armtronix/Wifi-Arduino-85/Schematic_BOM_V_0_4/Assembly Drawing.pdf

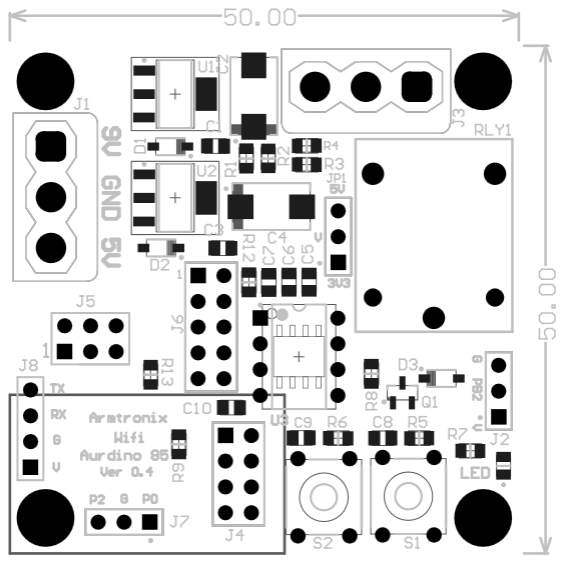
[picture p17: figure]
