armtronix/Wifi-Arduino-85/Schematic_BOM_V_0_4/Wifi_0V8_ 0V4_Corrected.pdf

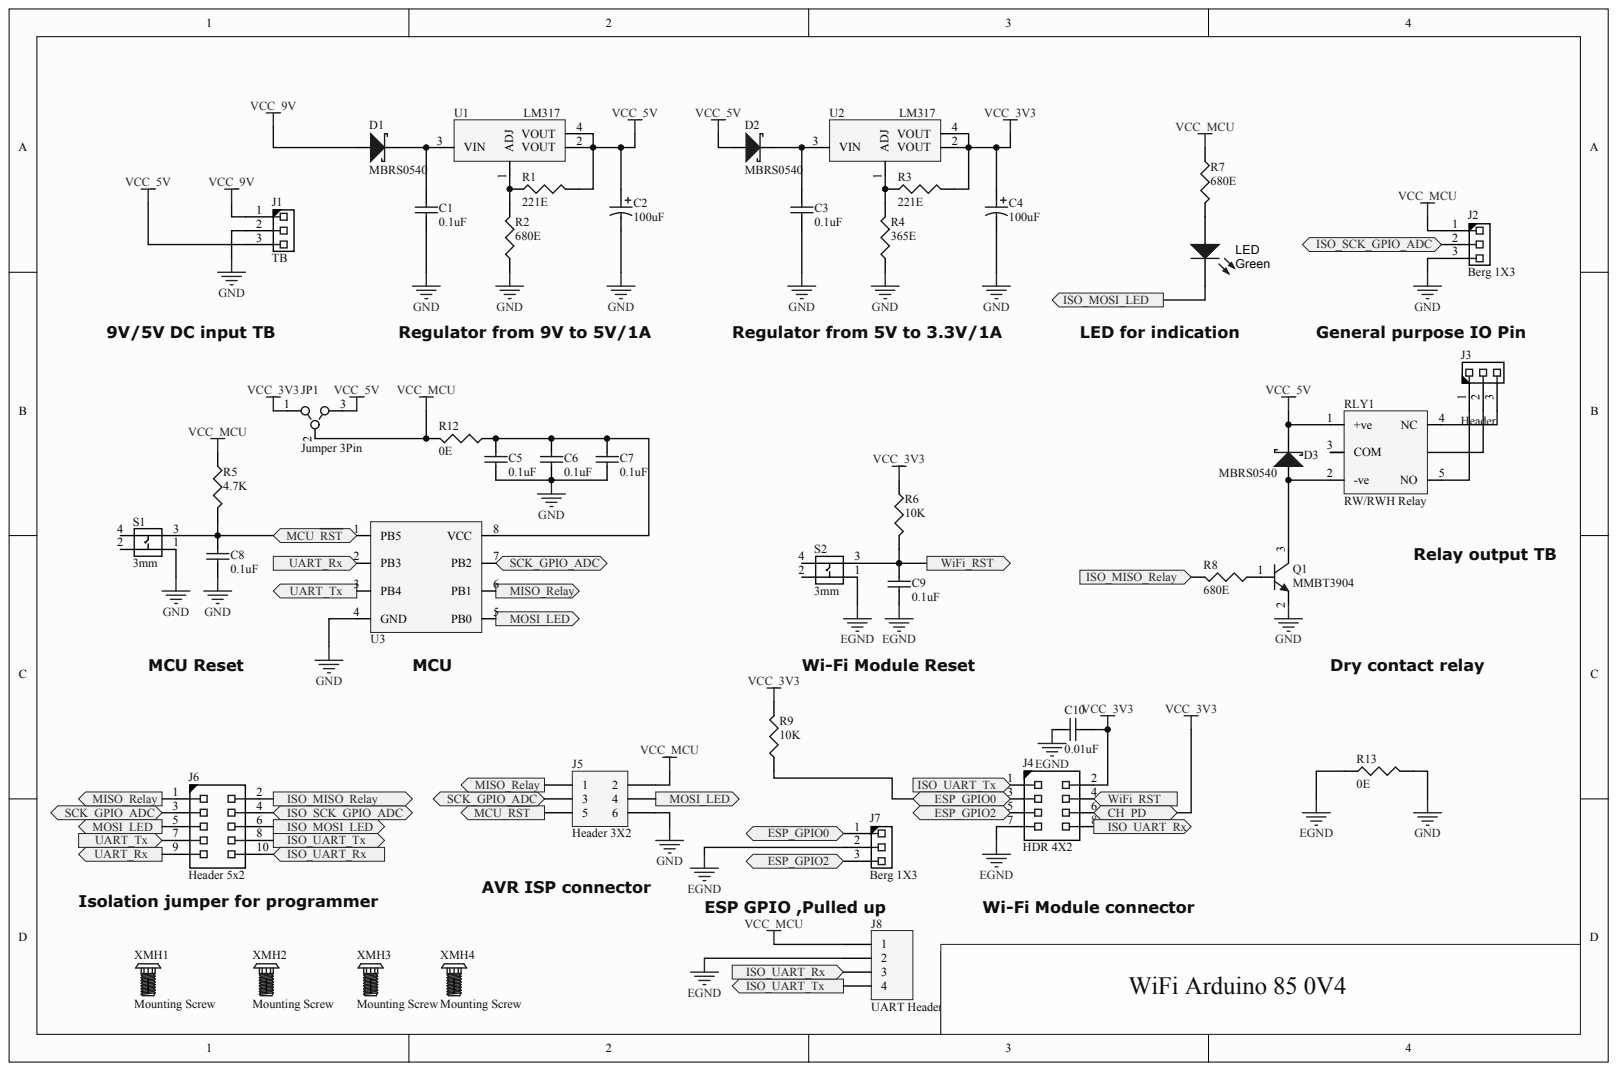
[picture p18: page 1]

General purpose IO Pin

EGND
ESP GPIO ,Pulled up

Isolation jumper for programmer

Wi-Fi Module connector

Wi-Fi Title | Altium Limited L3, 12a Rodborough Rd Frenchs Forest NSW Australia 2086
Size: A4 | WiFi Arduino 85 0V4 Number: 1 | Revision: 0.6

Date: 20-02-2016 Time: AM 09:10:39 | | Sheet 1 of 1
File: D:\PCB Projects\Wifi_Arduino_85\AltiumProject\Wifi 0V4\Wifi 0V8.SchDoc
