armtronix/Wifi-Arduino-85/Schematic_BOM_V_0_4/Wifi Schematic_0V8_ 0V4.pdf

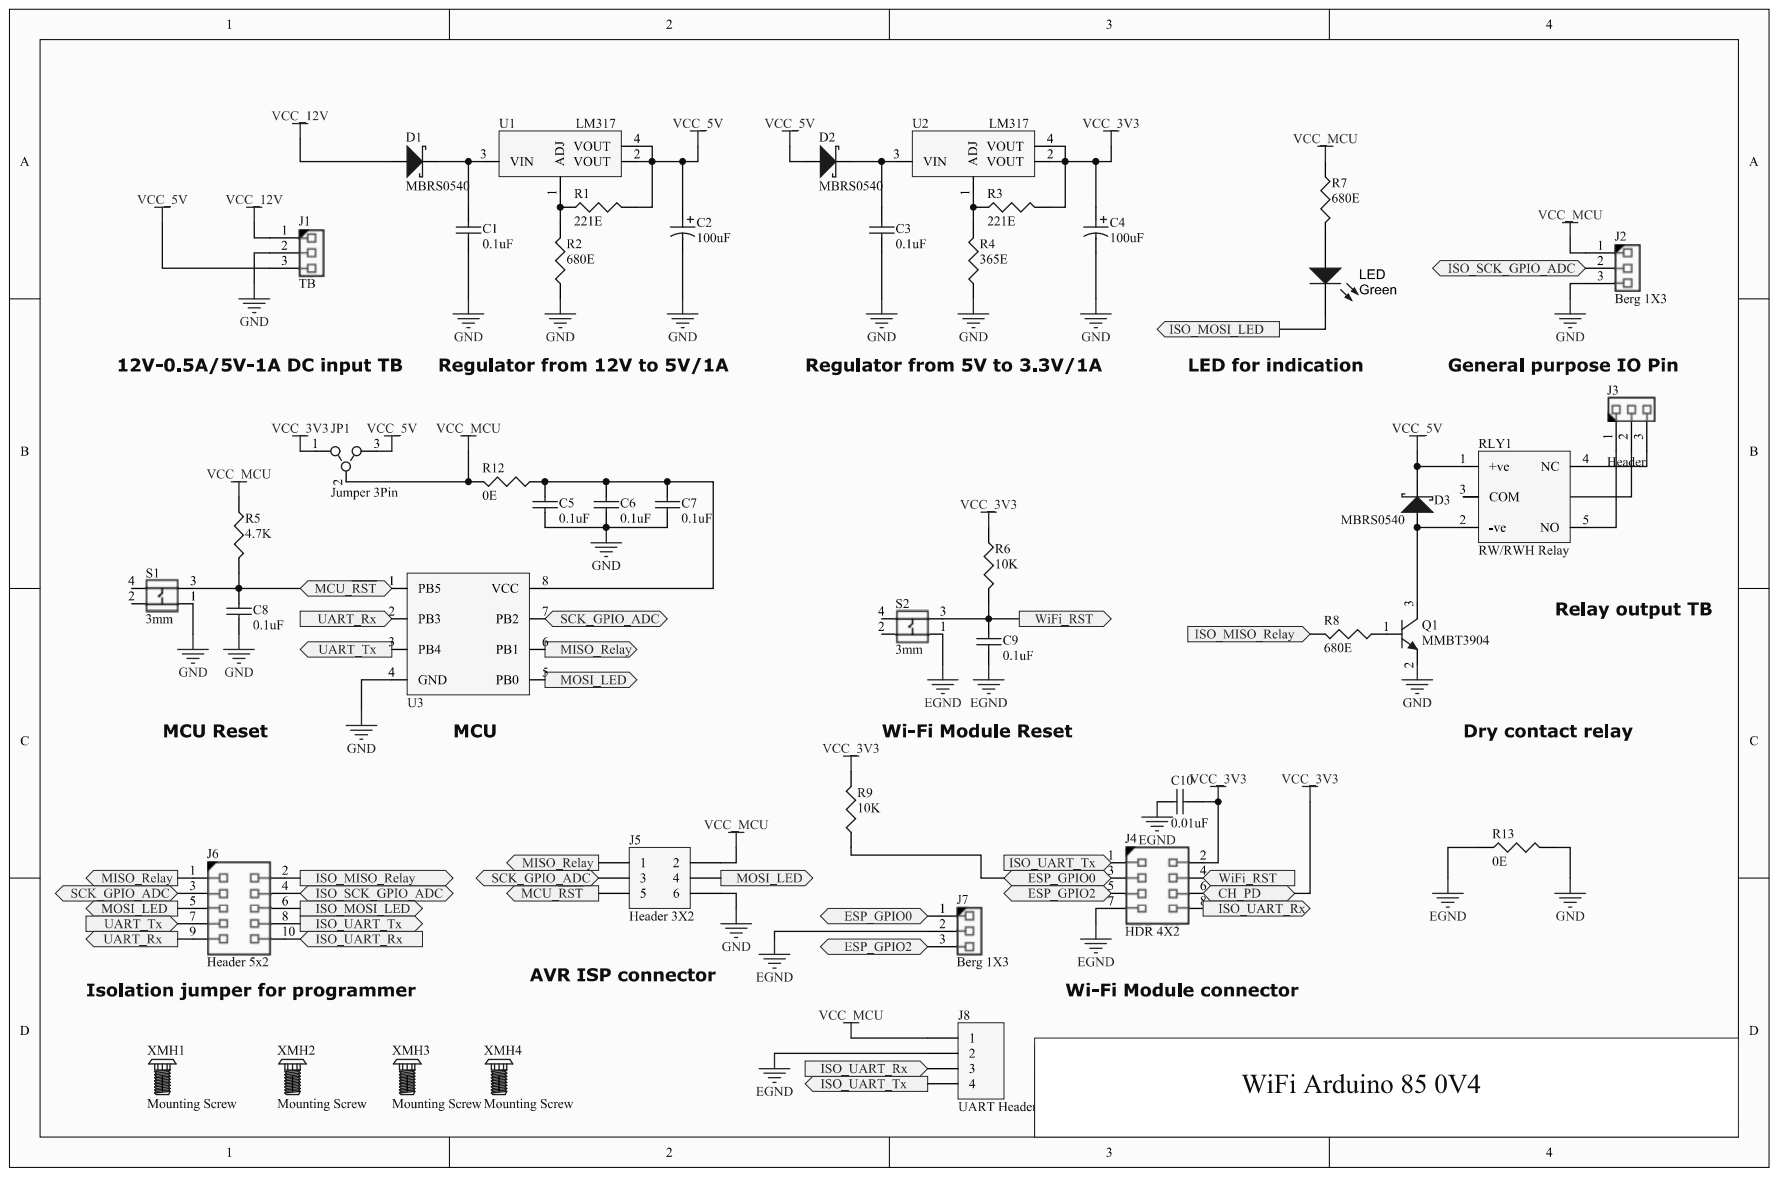
[picture p19: page 1]
