armtronix/Wifi-Arduino-85/Arduino Code/Wifi-Arduino-85-Switch-Esp-01/mqttFunctions.ino

boolean connectMQTT(){
  if (mqttClient.connected()){
    return true;
  }  
  
  Serial.print("Connecting to MQTT server ");
  Serial.print(mqttServer);
  Serial.print(" as ");
  Serial.println(host);
  
  if (mqttClient.connect(host)) {
    Serial.println("Connected to MQTT broker");
    if(mqttClient.subscribe((char*)subTopic.c_str())){
      Serial.println("Subsribed to topic.");
    } else {
      Serial.println("NOT subsribed to topic!");      
    }
    return true;
  }
  else {
    Serial.println("MQTT connect failed! ");
    return false;
  }
}

void disconnectMQTT(){
  mqttClient.disconnect();
}

void mqtt_handler(){
  if (toPub==1){
    Debugln("DEBUG: Publishing state via MWTT");
    if(pubState()){
     toPub=0; 
    }
  }
  mqttClient.loop();
  delay(100); //let things happen in background
}

void mqtt_arrived(char* subTopic, byte* payload, unsigned int length) { // handle messages arrived 
  int i = 0;
  //Serial.print("MQTT message arrived:  topic: " + String(subTopic));
    // create character buffer with ending null terminator (string)
    
  for(i=0; i<length; i++) {    
    buf[i] = payload[i];
  }
  buf[i] = '\0';
  String msgString = String(buf);
  Serial.println(msgString);
//  if (msgString == "R13_ON"){
//      Serial.println("+ATturn_on");
//      //Serial.println(digitalRead(OUTPIN));      
//      //Serial.print("Switching light to "); 
//      //Serial.println("high");
//      //digitalWrite(OUTPIN, 1); 
//  } else if (msgString == "R13_OFF"){
//      Serial.println("+ATturn_off");
      //Serial.println(digitalRead(OUTPIN));    
      //Serial.print("Switching light to "); 
     // Serial.println("low");
     // digitalWrite(OUTPIN, 0); 
//  }
//  if (msgString == "Led_on"){
//      Serial.print("Led is ");
//      Serial.println(digitalRead(OUTLED));      
//      Serial.print("Switching LED to "); 
//      Serial.println("high");
//      digitalWrite(OUTLED, 1); 
//  } else if (msgString == "Led_off"){
//      Serial.print("Led is ");
//      Serial.println(digitalRead(OUTLED));    
//      Serial.print("Switching LED to "); 
//      Serial.println("low");
//      digitalWrite(OUTLED, 0); 
//  }        
}

boolean pubState(){ //Publish the current state of the light  
  char serialinData[30];
  char serialinChar=-1; 
  byte serialIndex = 0;
  int stringComplete = 0;  
  if (!connectMQTT()){
      delay(100);
      if (!connectMQTT){                            
        Serial.println("Could not connect MQTT.");
        Serial.println("Publish state NOK");
        return false;
      }
    }
    if (mqttClient.connected()){
      
       while (Serial.available()) {
    // read the most recent byte (which will be from 0 to 255):

    if(serialIndex < 29) // One less than the size of the array
        {
            serialinChar = Serial.read(); // Read a character
            serialinData[serialIndex] = serialinChar; // Store it
            serialIndex++; // Increment where to write next
            serialinData[serialIndex] = '\0'; // Null terminate the string
        }
    
    //String attiny_Data = String(Serial.read(),HEX);
    if (serialinChar == '\n') {
      stringComplete=1;
    }
    
   }
   delay(350);
   
    if(stringComplete==1)
    {
         //Serial.println(WiFi.localIP());
         //delay(300);
         mqttClient.publish((char*)pubTopic.c_str(),serialinData);
         
         for (int i=0;i<19;i++)
         {
            serialinData[i]=0;
         }
        serialIndex=0;
        stringComplete=0;
        
     }
        
        //String state = (digitalRead(OUTPIN))?"1":"0";
      //  Serial.println("To publish state " + state );  
      if (mqttClient.publish((char*)pubTopic.c_str(), (char*) state.c_str())) {
        Serial.println("Publish state OK");        
        return true;
      } else {
        Serial.println("Publish state NOK");        
        return false;
      }
     } else {
         Serial.println("Publish state NOK");
         Serial.println("No MQTT connection.");        
     }    
}
