armtronix/Wifi-Arduino-85/(commit log)

2015-05-10 Wifi Arduino 85 Board Files
    Its a board where esp8266 ,Attiny 85 and Relay is used. These are the
    code and example files
2016-02-15 Added schematic and BOM
2016-02-15 Added important readme file for9V/12V input and instructable link
2016-02-20 Corrected Schematic added
2016-02-20 Assembly Layout added
2016-04-17 Wifi Switch code added for esp and attiny85
2016-04-17 Wifi Switch code corrected and modified for esp
    [Wifi-Arduino-85-Switch-Esp-01.ino, mqttFunctions.ino, serverFunctions.ino]
2016-04-17 Wifi Switch generic arduino libraries added for esp
